tLLWtG/Smart-ePaper/docs/bmp/TLLWG.bmp

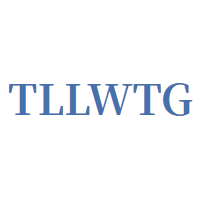
docs/bmp/TLLWG.bmp
