tLLWtG/Smart-ePaper/docs/bmp/字模选项.png

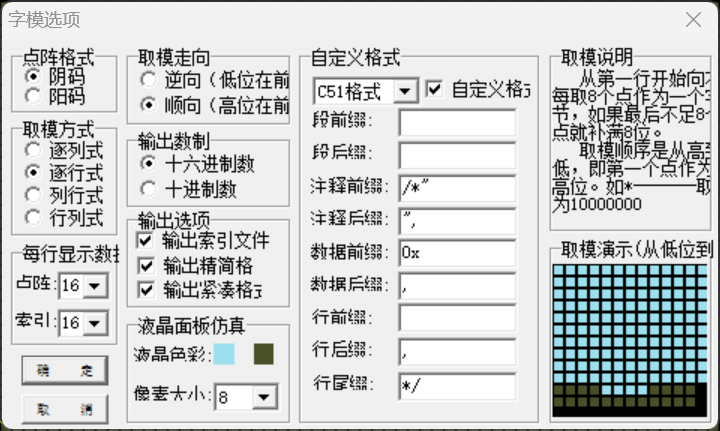
docs/bmp/字模选项.png
