tLLWtG/Smart-ePaper/docs/schematic.pdf

# 29 35 30 36 31 37 32 38 33 39 34 40 35 41 36 42 37 RX 38 TX 39 2

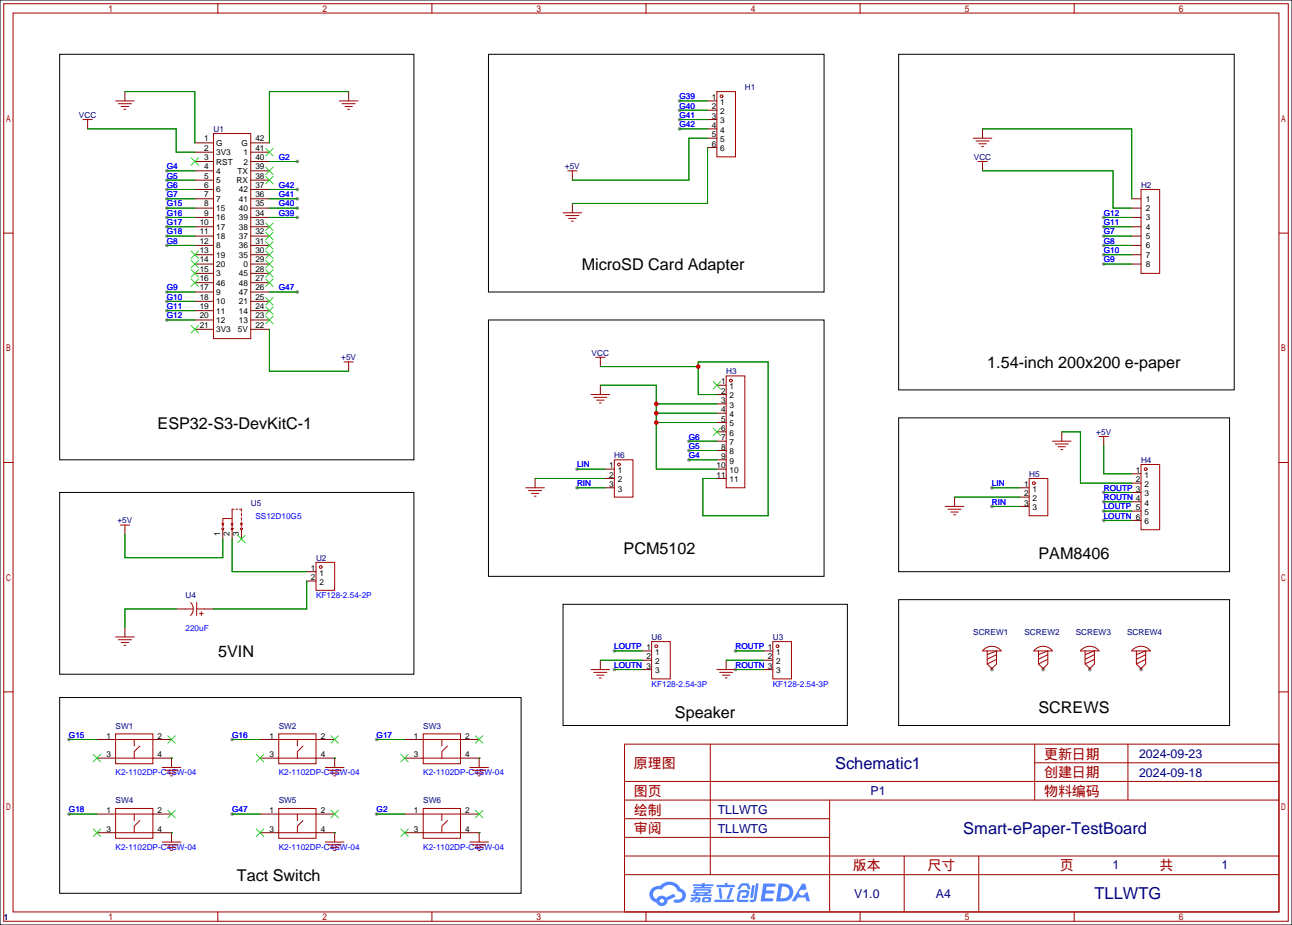
[picture p7: page 1]
