tLLWtG/Smart-ePaper/(list of files, drawings)

Other design files:
docs/Smart-ePaper-TestBoard.eprj
