tLLWtG/Smart-ePaper/Smart-ePaper/src/BaseDisplay.cpp

#include "BaseDisplay.h"

void display_CenterFullWindow(const char *str)
{
  Serial.println("display_CenterFullWindow");
  display.setRotation(0);
  display.setFont(&FreeMonoBold9pt7b);
  display.setTextColor(GxEPD_BLACK);
  int16_t tbx, tby; uint16_t tbw, tbh;
  display.getTextBounds(str, 0, 0, &tbx, &tby, &tbw, &tbh);
  // center bounding box by transposition of origin:
  uint16_t x = ((display.width() - tbw) / 2) - tbx;
  uint16_t y = ((display.height() - tbh) / 2) - tby;
  display.setFullWindow();

  display.firstPage();
  do
  {
    display.fillScreen(GxEPD_WHITE);
    display.setCursor(x, y);
    display.print(str);
  }
  while (display.nextPage());
  Serial.println("display_CenterFullWindow done");
}

void display_CenterPartialWindow(const char *str)
{
  Serial.println("display_CenterPartialWindow");
  display.setPartialWindow(0, 0, display.width(), display.height());
  display.setRotation(0);
  display.setFont(&FreeMonoBold9pt7b);
  display.setTextColor(GxEPD_BLACK);
  int16_t tbx, tby; uint16_t tbw, tbh;
  display.getTextBounds(str, 0, 0, &tbx, &tby, &tbw, &tbh);
  uint16_t umx = ((display.width() - tbw) / 2) - tbx;
  uint16_t umy = ((display.height() / 2) - tbh / 2) - tby;

  display.firstPage();
  do
  {
    display.fillScreen(GxEPD_WHITE);
    display.setCursor(umx, umy);
    display.print(str);
  }
  while (display.nextPage());
  Serial.println("display_CenterPartialWindow done");
}

void display_clearScreen()
{
  Serial.println("display_clearScreen");
  display.setRotation(0);
  display.setFullWindow();

  display.firstPage();
  do
  {
    display.fillScreen(GxEPD_WHITE);
  }
  while (display.nextPage());
  Serial.println("display_clearScreen");
}

void display_helloWorld()
{
  Serial.println("display_helloWorld");
  const char HelloWorld[] = "Hello World!";
  display.setRotation(0);
  display.setFont(&FreeMonoBold9pt7b);
  display.setTextColor(GxEPD_BLACK);
  int16_t tbx, tby; uint16_t tbw, tbh;
  display.getTextBounds(HelloWorld, 0, 0, &tbx, &tby, &tbw, &tbh);
  // center bounding box by transposition of origin:
  uint16_t x = ((display.width() - tbw) / 2) - tbx;
  uint16_t y = ((display.height() - tbh) / 2) - tby;
  display.setFullWindow();

  display.firstPage();
  do
  {
    display.fillScreen(GxEPD_WHITE);
    display.setCursor(x, y);
    display.print(HelloWorld);
  }
  while (display.nextPage());
  Serial.println("display_helloWorld done");
}

void display_helloWorld_PartialMode()
{
  Serial.println("display_helloWorld_PartialMode");
  const char HelloWorld[] = "Hello World!";
  display.setPartialWindow(0, 0, display.width(), display.height());
  display.setRotation(0);
  display.setFont(&FreeMonoBold9pt7b);
  display.setTextColor(GxEPD_BLACK);
  int16_t tbx, tby; uint16_t tbw, tbh;
  display.getTextBounds(HelloWorld, 0, 0, &tbx, &tby, &tbw, &tbh);
  uint16_t umx = ((display.width() - tbw) / 2) - tbx;
  uint16_t umy = ((display.height() / 2) - tbh / 2) - tby;

  display.firstPage();
  do
  {
    display.fillScreen(GxEPD_WHITE);
    display.setCursor(umx, umy);
    display.print(HelloWorld);
  }
  while (display.nextPage());
  Serial.println("display_helloWorld_PartialMode done");
}

void display_helloWorld_GB2312()
{
  Serial.println("display_helloWorld_GB2312");
  display.setRotation(0);
  display.setFullWindow();
  u8g2dp.setFont(gb2312);
  u8g2dp.setForegroundColor(GxEPD_BLACK);
  u8g2dp.setBackgroundColor(GxEPD_WHITE);

  display.firstPage();
  do
  {
    u8g2dp.setCursor(65, 100);
    u8g2dp.println("你好，世界！");
  }
  while (display.nextPage());
  Serial.println("display_helloWorld_GB2312 done");
}

void display_helloWorld_GB2312_PartialMode()
{
  Serial.println("display_helloWorld_GB2312_PartialMode");
  display.setRotation(0);
  display.setPartialWindow(0, 0, display.width(), display.height());
  u8g2dp.setFont(gb2312);
  u8g2dp.setForegroundColor(GxEPD_BLACK);
  u8g2dp.setBackgroundColor(GxEPD_WHITE);

  display.firstPage();
  do
  {
    u8g2dp.setCursor(65, 100);
    u8g2dp.println("你好，世界！");
  }
  while (display.nextPage());
  Serial.println("display_helloWorld_GB2312_PartialMode done");
}

void display_Logo()
{
  Serial.println("display_Logo");
  display.setRotation(0);
  display.setFullWindow();
  display.firstPage();
  do
  {
    display.drawBitmap(0, 0, LOGO, 200, 200, GxEPD_BLACK, GxEPD_WHITE);
  }
  while (display.nextPage());
  Serial.println("display_Logo done");
}

void display_Index()
{
  Serial.println("display_Index");

  uint16_t x = 0, y = 0;
  switch (Index_sel)
  {
    case PageStatus_MP3_Sel:
      x = 75, y = 24;
      break;
    case PageStatus_Reader_Sel:
      x = 165, y = 24;
      break;
    case PageStatus_Weather:
      x = 75, y = 114;
      break;
    case PageStatus_Hitokoto:
      x = 165, y = 114;
      break;
  }

  display.setRotation(0);
  display.setPartialWindow(0, 0, 200, 200);
  u8g2dp.setFont(gb2312);
  u8g2dp.setForegroundColor(GxEPD_BLACK);
  u8g2dp.setBackgroundColor(GxEPD_WHITE);
  
  display.firstPage();
  do
  {
    display.drawRoundRect(10, 10, 180, 180, 8, GxEPD_BLACK);
    display.drawLine(10, 100, 190, 100, GxEPD_BLACK);
    display.drawLine(100, 10, 100, 190, GxEPD_BLACK);
    
    u8g2dp.setCursor(42, 35);
    u8g2dp.print("音乐");
    u8g2dp.setCursor(132, 35);
    u8g2dp.print("阅读");
    u8g2dp.setCursor(42, 125);
    u8g2dp.print("天气");
    u8g2dp.setCursor(132, 125);
    u8g2dp.print("一言");

    display.drawBitmap(35, 45, ICON_MUSIC, 40, 40, GxEPD_BLACK);
    display.drawBitmap(125, 45, ICON_BOOK, 40, 40, GxEPD_BLACK);
    display.drawBitmap(35, 135, ICON_WEATHER, 40, 40, GxEPD_BLACK);
    display.drawBitmap(125, 135, ICON_QUOTE, 40, 40, GxEPD_BLACK);

    display.drawBitmap(x, y, ICON_ARROW, 15, 11, GxEPD_BLACK);
  }
  while (display.nextPage());

  Serial.println("display_Index done");
}

void display_MP3_Sel()
{
  Serial.println("display_MP3_Sel");

  
  display.setRotation(0);
  display.setPartialWindow(0, 0, 200, 200);
  u8g2dp.setFont(gb2312);
  u8g2dp.setForegroundColor(GxEPD_BLACK);
  u8g2dp.setBackgroundColor(GxEPD_WHITE);

  display.firstPage();
  do
  {
    display.fillRoundRect(0, 6, 200, 5, 3, GxEPD_BLACK);
    display.fillRoundRect(0, 190, 200, 5, 3, GxEPD_BLACK);

    for (int i = 0; i <= 7; ++i)
    {
      display.drawLine(0, 30 + i * 20, 200, 30 + i * 20, GxEPD_BLACK);
    }
    
    for (int i = mlist_l; i <= mlist_r; ++i)
    {
      if (i < music_list.size())
      {
        u8g2dp.setCursor(5, 27 + (i - mlist_l) * 20);
        u8g2dp.println(music_list[i]);
      }
    }

    display.drawBitmap(180, 15 + (mlist_loc - mlist_l) * 20, ICON_ARROW, 15, 11, GxEPD_BLACK);
  }
  while (display.nextPage());

  Serial.println("display_MP3_Sel done");
}

void display_MP3_Play()
{
  Serial.println("display_MP3_Play");

  display.setRotation(0);
  display.setPartialWindow(0, 0, 200, 200);
  u8g2dp.setFont(gb2312);
  u8g2dp.setForegroundColor(GxEPD_BLACK);
  u8g2dp.setBackgroundColor(GxEPD_WHITE);

  display.firstPage();
  do
  {
    display.drawRoundRect(5, 5, 190, 190, 8, GxEPD_BLACK);

    u8g2dp.setCursor(10, 25);
    u8g2dp.println(music_list[mlist_loc]);
    
    display.drawBitmap(74, 90, ICON_STARTSTOP, 50, 31, GxEPD_BLACK);
    display.drawBitmap(85, 40, ICON_PLUS, 30, 30, GxEPD_BLACK);
    display.drawBitmap(85, 145, ICON_SUB, 30, 30, GxEPD_BLACK);
    display.drawBitmap(15, 90, ICON_NEXT, 50, 31, GxEPD_BLACK);
    display.drawBitmap(135, 90, ICON_PREVIOUS, 50, 31, GxEPD_BLACK);

    u8g2dp.setCursor(10, 40);
    u8g2dp.printf("Index: %d", mlist_loc);
    u8g2dp.setCursor(130, 187);
    u8g2dp.printf("Vol: %.2f", myVolume);
  }
  while (display.nextPage());

  Serial.println("display_MP3_Play done");
}

void display_Weather()
{
  Serial.println("display_Weather");

  display.setRotation(0);
  display.setPartialWindow(0, 0, 200, 200);
  u8g2dp.setFont(gb2312);
  u8g2dp.setForegroundColor(GxEPD_BLACK);
  u8g2dp.setBackgroundColor(GxEPD_WHITE);

  bool connected = WiFi.status() == WL_CONNECTED;
  if (!connected)
  {
    display.firstPage();
    do
    {
      display.drawRoundRect(5, 5, 190, 190, 8, GxEPD_BLACK);

      u8g2dp.setCursor(10, 20);
      u8g2dp.println("Weather");
      u8g2dp.setCursor(10, 40);
      u8g2dp.println("Connecting to WiFi...");
      u8g2dp.setCursor(10, 60);
      u8g2dp.println("(若长时间处于连接状态，请");
      u8g2dp.setCursor(10, 80);
      u8g2dp.println("检查 WiFi 或重新配网。");
      u8g2dp.setCursor(10, 100);
      u8g2dp.println("另: 左键可删除配网信息，");
      u8g2dp.setCursor(10, 120);
      u8g2dp.println("删除后需重启设备以应用。)");
    }
    while (display.nextPage());
  }
  else
  {
    Realtime_weather rw = get_realtime_weather();
    Forecast_weather fw = get_forecast_weather();
    Air_data ad = get_air_data();
    if (rw.updateTime.isEmpty() && fw.updateTime.isEmpty() && ad.updateTime.isEmpty())
    {
      display.firstPage();
      do
      {
        display.drawRoundRect(5, 5, 190, 190, 8, GxEPD_BLACK);

        u8g2dp.setCursor(10, 20);
        u8g2dp.println("Weather");
        u8g2dp.setCursor(10, 40);
        u8g2dp.println("无法从服务器获取数据。");
      }
      while (display.nextPage());
    }
    else
    {
      display.firstPage();
      do
      {
        display.drawRoundRect(5, 5, 190, 190, 8, GxEPD_BLACK);

        u8g2dp.setCursor(10, 20);
        u8g2dp.printf("Weather        updTime--%s", rw.updateTime);
        u8g2dp.setCursor(10, 40);
        u8g2dp.printf("实时天气:%s;T:%s;H:%s", rw.text, rw.temp, rw.humidity);
        u8g2dp.setCursor(10, 60);
        u8g2dp.printf("%s%s级;aqi:%s%s", rw.windDir, rw.windScale, ad.aqi, ad.category);

        u8g2dp.setCursor(10, 80);
        u8g2dp.printf("%s     气温:%s-%s", fw.fxDate[0], fw.tempMin[0], fw.tempMax[0]);
        u8g2dp.setCursor(10, 100);
        u8g2dp.printf("早晚天气:%s-%s", fw.textDay[0], fw.textNight[0]);

        u8g2dp.setCursor(10, 120);
        u8g2dp.printf("%s     气温:%s-%s", fw.fxDate[1], fw.tempMin[1], fw.tempMax[1]);
        u8g2dp.setCursor(10, 140);
        u8g2dp.printf("早晚天气:%s-%s", fw.textDay[1], fw.textNight[1]);

        u8g2dp.setCursor(10, 160);
        u8g2dp.printf("%s     气温:%s-%s", fw.fxDate[2], fw.tempMin[2], fw.tempMax[2]);
        u8g2dp.setCursor(10, 180);
        u8g2dp.printf("早晚天气:%s-%s", fw.textDay[2], fw.textNight[2]);
        
      }
      while (display.nextPage());
    }
  }

  Serial.println("display_Weather done");
}

void display_Hitokoto()
{
  Serial.println("display_Hitokoto");
  display.setRotation(0);
  display.setPartialWindow(0, 0, 200, 200);
  u8g2dp.setFont(gb2312);
  u8g2dp.setForegroundColor(GxEPD_BLACK);
  u8g2dp.setBackgroundColor(GxEPD_WHITE);

  bool connected = WiFi.status() == WL_CONNECTED;
  if (!connected)
  {
    display.firstPage();
    do
    {
      u8g2dp.setCursor(0, 20);
      u8g2dp.println("Hitokoto");
      u8g2dp.setCursor(0, 40);
      u8g2dp.println("Connecting to WiFi...");
      u8g2dp.setCursor(0, 60);
      u8g2dp.println("(若长时间处于连接状态，请");
      u8g2dp.setCursor(0, 80);
      u8g2dp.println("检查 WiFi 或重新配网。");
      u8g2dp.setCursor(0, 100);
      u8g2dp.println("另: 左键可删除配网信息，");
      u8g2dp.setCursor(0, 120);
      u8g2dp.println("删除后需重启设备以应用。)");
    }
    while (display.nextPage());
  }
  else
  {
    Hitokoto ht = get_hitokoto();
    if (ht.hitokoto.isEmpty())
    {
      display.firstPage();
      do
      {
        u8g2dp.setCursor(0, 20);
        u8g2dp.println("Hitokoto");
        u8g2dp.setCursor(0, 40);
        u8g2dp.println("无法从服务器获取数据。");
      }
      while (display.nextPage());
    }
    else
    {
      display.firstPage();
      do
      {
        u8g2dp.setCursor(0, 20);
        u8g2dp.printf("Hitokoto");
        u8g2dp.setCursor(20, 40);
        
        int count = 0, i = 0, ccount = 0;
        while (i < ht.hitokoto.length())
        {
          int charLen = 1;
          unsigned char byte = ht.hitokoto[i];

          if (byte >= 0xC0)
          {
            if ((byte & 0xF0) == 0xE0) charLen = 3; // 3字节字符
            else if ((byte & 0xF8) == 0xF0) charLen = 4; // 4字节字符
            else charLen = 2; // 2字节字符
          }
          u8g2dp.print(ht.hitokoto.substring(i, i + charLen));
          count++;
          if ((ccount == 0 && count >= 13) || (count >= 14))
          {
            count = 0;
            ++ccount;
            u8g2dp.setCursor(0, 40 + ccount * 20);
          }
          i += charLen;
        }

        u8g2dp.setCursor(0, 160);
        u8g2dp.printf("from:%s", ht.from);
      }
      while (display.nextPage());
    }
  }
  Serial.println("display_Hitokoto done");
}

void display_Reader_Sel()
{
  Serial.println("display_Reader_Sel");

  display.setRotation(0);
  display.setPartialWindow(0, 0, 200, 200);
  u8g2dp.setFont(gb2312);
  u8g2dp.setForegroundColor(GxEPD_BLACK);
  u8g2dp.setBackgroundColor(GxEPD_WHITE);

  display.firstPage();
  do
  {
    display.fillRoundRect(0, 6, 200, 5, 3, GxEPD_BLACK);
    display.fillRoundRect(0, 190, 200, 5, 3, GxEPD_BLACK);

    for (int i = 0; i <= 7; ++i)
    {
      display.drawLine(0, 30 + i * 20, 200, 30 + i * 20, GxEPD_BLACK);
    }
    
    for (int i = tlist_l; i <= tlist_r; ++i)
    {
      if (i < txt_list.size())
      {
        u8g2dp.setCursor(5, 27 + (i - tlist_l) * 20);
        u8g2dp.println(txt_list[i]);
      }
    }

    display.drawBitmap(180, 15 + (tlist_loc - tlist_l) * 20, ICON_ARROW, 15, 11, GxEPD_BLACK);
  }
  while (display.nextPage());

  Serial.println("display_Reader_Sel done");
}

void display_Reader()
{
  // TODO
  Serial.println("display_Reader");

  display.setRotation(0);
  display.setPartialWindow(0, 0, 200, 200);
  u8g2dp.setFont(gb2312);
  u8g2dp.setForegroundColor(GxEPD_BLACK);
  u8g2dp.setBackgroundColor(GxEPD_WHITE);

  display.firstPage();
  do
  {
    u8g2dp.setCursor(0, 20);
    u8g2dp.printf("Reader");
    u8g2dp.setCursor(20, 40);
    u8g2dp.println("// TODO");
    u8g2dp.setCursor(0, 40);
    u8g2dp.println("前面的区域，以后再来探索吧！");
  }
  while (display.nextPage());

  Serial.println("display_Reader done");
}

const uint8_t LOGO[] PROGMEM =
{
  0x00,0x00,0x00,0x00,0x00,0x00,0x00,0x00,0x00,0x00,0x00,0x00,0x00,0x00,0x00,0x00,
  0x00,0x00,0x00,0x00,0x00,0x00,0x00,0x00,0x00,0x00,0x00,0x00,0x00,0x00,0x00,0x00,
  0x00,0x00,0x00,0x00,0x00,0x00,0x00,0x00,0x00,0x00,0x00,0x00,0x00,0x00,0x00,0x00,
  0x00,0x00,0x00,0x00,0x00,0x00,0x00,0x00,0x00,0x00,0x00,0x00,0x00,0x00,0x00,0x00,
  0x00,0x00,0x00,0x00,0x00,0x00,0x00,0x00,0x00,0x00,0x00,0x00,0x00,0x00,0x00,0x00,
  0x00,0x00,0x00,0x00,0x00,0x00,0x00,0x00,0x00,0x00,0x00,0x00,0x00,0x00,0x00,0x00,
  0x00,0x00,0x00,0x00,0x00,0x00,0x00,0x00,0x00,0x00,0x00,0x00,0x00,0x00,0x00,0x00,
  0x00,0x00,0x00,0x00,0x00,0x00,0x00,0x00,0x00,0x00,0x00,0x00,0x00,0x00,0x00,0x00,
  0x00,0x00,0x00,0x00,0x00,0x00,0x00,0x00,0x00,0x00,0x00,0x00,0x00,0x00,0x00,0x00,
  0x00,0x00,0x00,0x00,0x00,0x00,0x00,0x00,0x00,0x00,0x00,0x00,0x00,0x00,0x00,0x00,
  0x00,0x00,0x00,0x00,0x00,0x00,0x00,0x00,0x00,0x00,0x00,0x00,0x00,0x00,0x00,0x00,
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
  0xFF,0xFF,0xFF,0xFC,0x00,0x00,0x00,0x00,0x00,0x00,0x00,0x00,0x00,0x00,0x00,0x00,
  0x00,0x00,0x00,0x00,0x00,0x00,0x00,0x00,0x00,0x00,0x00,0x00,0x00,0x00,0x00,0x00,
  0x00,0x00,0x00,0x00,0x00,0x00,0x00,0x00,0x00,0x00,0x00,0x00,0x00,0x00,0x00,0x00,
  0x00,0x00,0x00,0x00,0x00,0x00,0x00,0x00,
};
