tLLWtG/Smart-ePaper/(commit log)

2024-09-22 Fix "自动播放下一首后页面未刷新".
2024-09-27 Add eprj.
    [Smart-ePaper-TestBoard.eprj]
